jacey0-0/EE1111A-Project/schematic/BOM.csv

Reference | Value | Datasheet | Footprint | Qty | DNP
BT1 | Battery_Cell | Li-On Battery, 1 Single Cell |  | 1
C1 | 100uF |  |  | 1
C2 | 47uF |  |  | 1
C3 | 0.1uF |  |  | 1
C4 | 100nF |  |  | 1
C5 | 10uF |  |  | 1
D1,D2 | 1N5819 |  |  | 2
J1 | Power |  | Connector_PinSocket_2.54mm:PinSocket_1x08_P2.54mm_Vertical | 1
J2,J4 | Digital/PWM |  | Connector_PinSocket_2.54mm:PinSocket_1x08_P2.54mm_Vertical,Connector_PinSocket_2.54mm:PinSocket_1x10_P2.54mm_Vertical | 2
J3 | Analog |  | Connector_PinSocket_2.54mm:PinSocket_1x06_P2.54mm_Vertical | 1
L1 | 150uH |  |  | 1
M1 | Motor_Servo |  |  | 1
Q1,Q6 | 2N2222 | https://ngspice.sourceforge.io/docs/ngspice-html-manual/manual.xhtml#cha_BJTs |  | 2
Q2 | PN2907A | https://ngspice.sourceforge.io/docs/ngspice-html-manual/manual.xhtml#cha_BJTs |  | 1
Q3 | IRF9530 | https://ngspice.sourceforge.io/docs/ngspice-html-manual/manual.xhtml#cha_MOSFETs |  | 1
Q4 | IRLZ44N | http://www.irf.com/product-info/datasheets/data/irlz44n.pdf | Package_TO_SOT_THT:TO-220-3_Vertical | 1
Q5 | Q_Dual_NMOS_G1S2G2D2S1D1 |  |  | 1
R1,R2,R4,R9 | 10k |  |  | 4
R3 | 1k |  |  | 1
R5 | 470 |  |  | 1
R6 | 0.5R |  |  | 1
R7 | 100R |  |  | 1
R8 | 180k |  |  | 1
R10 | 2k |  |  | 1
R11,R12 | A1060 | http://cdn-reichelt.de/documents/datenblatt/A500/A106012.pdf | OptoDevice:R_LDR_D6.4mm_P3.4mm_Vertical | 2
R13 | 4.7k |  |  | 1
SC1 | Solar_Cell | 5W 12V |  | 1
U1,U5 | INA219AxD | http://www.ti.com/lit/ds/symlink/ina219.pdf | Package_SO:SOIC-8_3.9x4.9mm_P1.27mm | 2
U2,U4 | LM358 | http://www.ti.com/lit/ds/symlink/lm2904-n.pdf |  | 2
U3 | DW01A | https://hmsemi.com/downfile/DW01A.PDF | Package_TO_SOT_SMD:SOT-23-6 | 1
