jacey0-0/EE1111A-Project/schematic/EE1111A.pdf

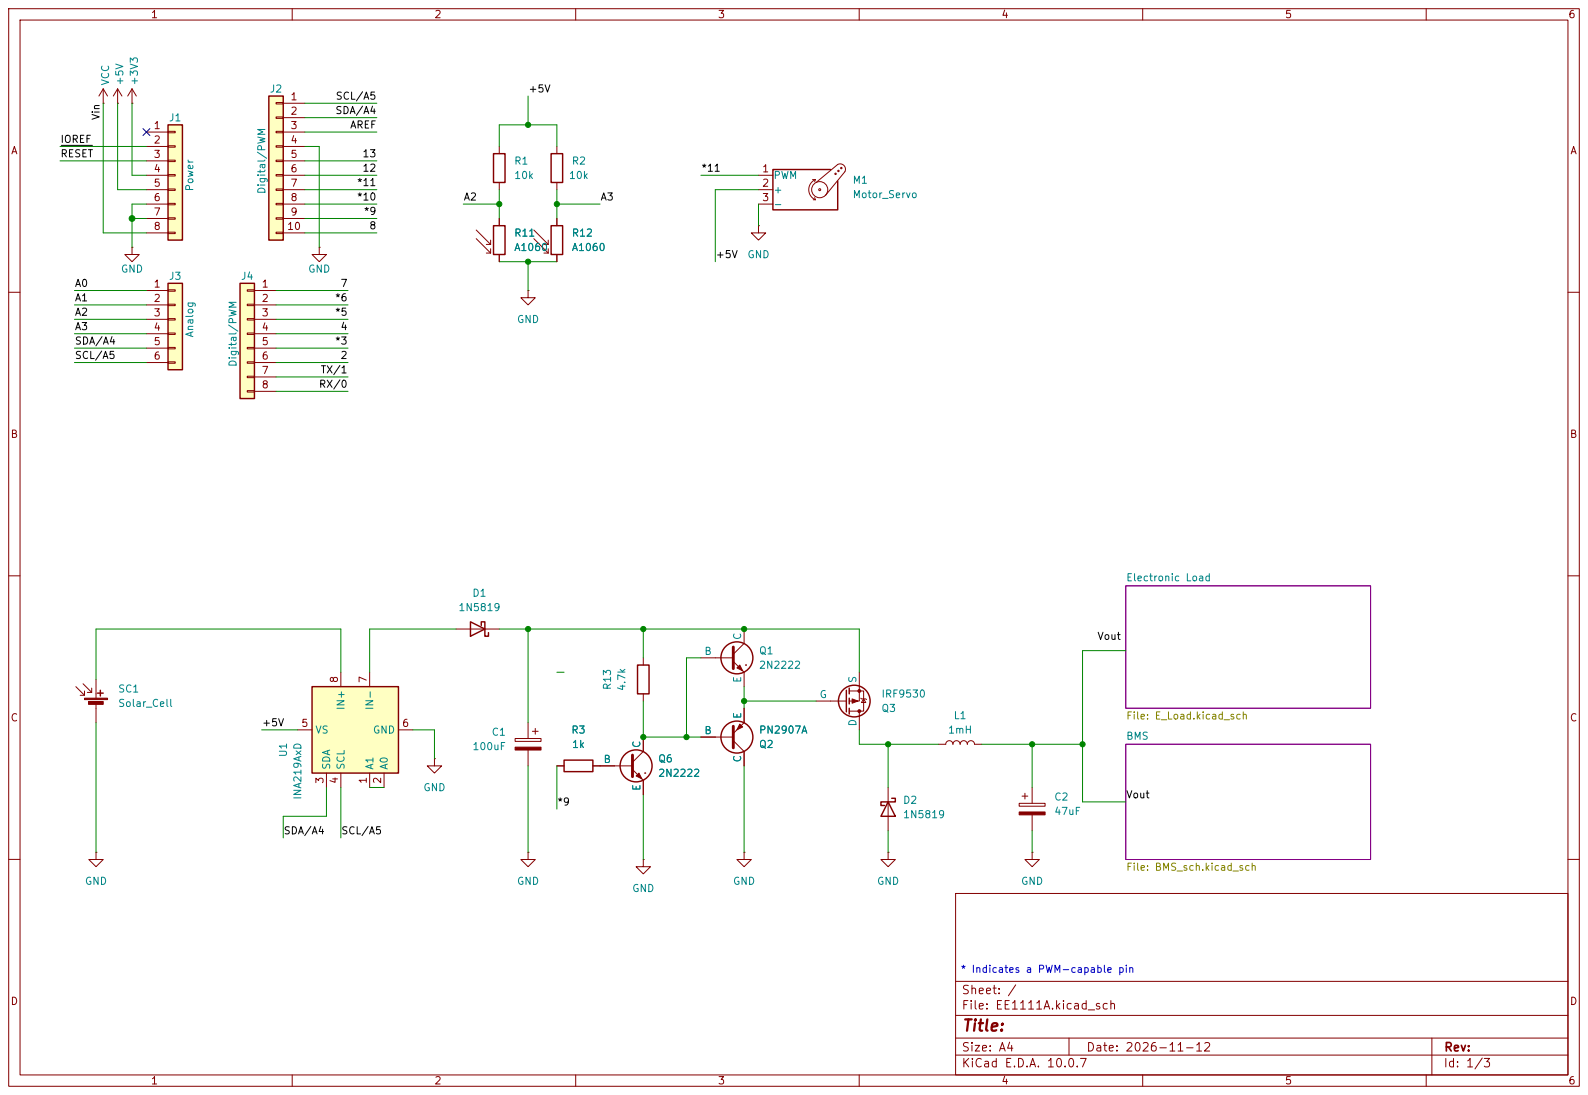
[picture p3: page 1]

* Indicates a PWM-capable pin Q2PN2907A C

Size: A4 | Rev:
KiCad E.D.A. 10.0.7 | Id: 1/3

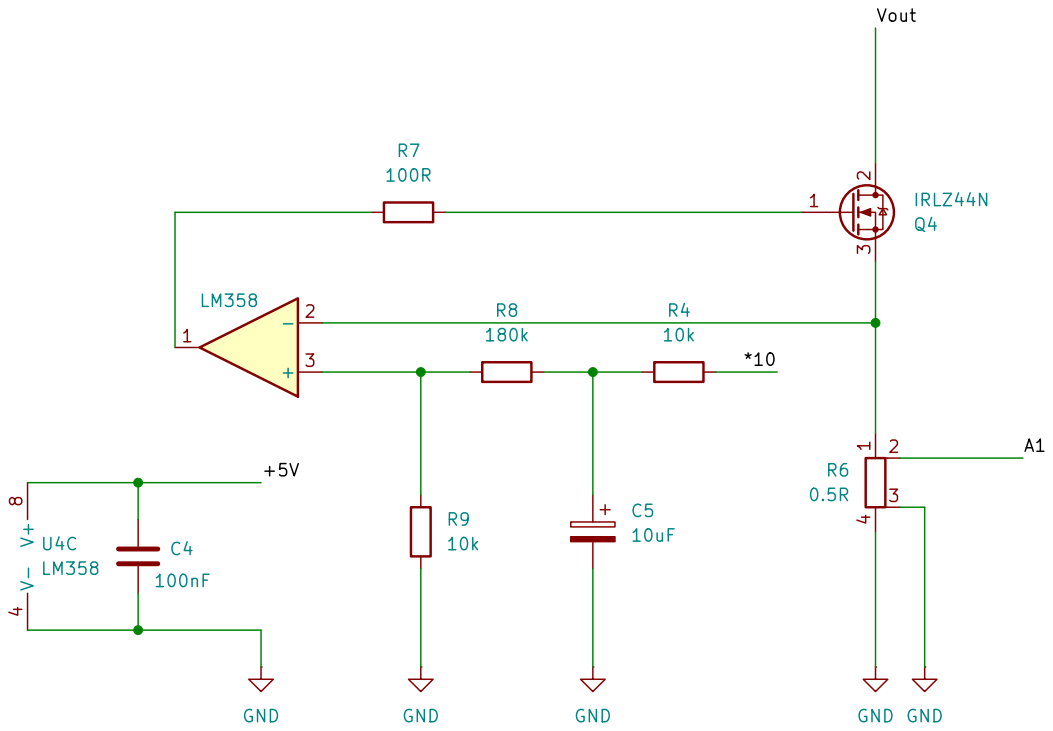
[picture p4: page 2]

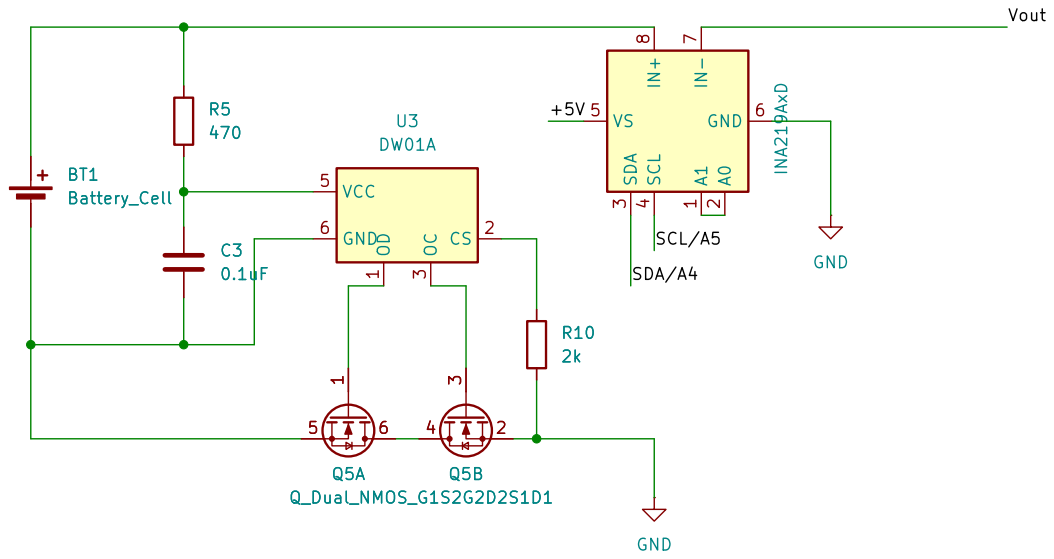
[picture p5: page 3]
