jacey0-0/EE1111A-Project/schematic/EE1111A.kicad_pcb

## KiCad design schematic/EE1111A.kicad_pcb (2026-10-20)


Board: 2 copper layers, 68.6 x 53.3 mm, 8 parts (0 on the bottom side), 3 nets, no tracks yet.

Parts:
J1: Power; PinSocket_1x08_P2.54mm_Vertical
J2: Digital/PWM; PinSocket_1x10_P2.54mm_Vertical
J3: Analog; PinSocket_1x06_P2.54mm_Vertical
J4: Digital/PWM; PinSocket_1x08_P2.54mm_Vertical
MH1, MH2, MH3, MH4: MountingHole_3.2mm

Connections:
/SCL/A5: J2.1, J3.6
/SDA/A4: J2.2, J3.5
GND: J1.6, J1.7, J2.4
