jacey0-0/EE1111A-Project/(commit log)

2026-10-15 Create BOM.md
    Bill of Materials
2026-10-20 Simulation Verified Schematic
    [EE1111A.kicad_sch]
2026-10-20 Convert BOM from markdown to CSV format
    [BOM.csv]
2026-10-20 Fixed Errors
    [BMS_sch.kicad_sch, EE1111A.kicad_pcb, EE1111A.kicad_sch, E_Load.kicad_sch]
2026-10-20 Fixed BOM.csv
    [BOM.csv]
2026-10-20 Basic Arduino Control Code
2026-11-10 Fixed Bugs and Tuned Tracking
    [Controller.ino]
2026-11-11 Revise README for comprehensive project documentation
    Updated README to include project overview, architecture, hardware selection, and detailed sections on buck converter design, PWM architecture, MPPT, battery management, programmable load, solar tracking, telemetry, and known limitations.
2026-11-11 Update known limitations and further work in README
    Expanded the known limitations section with detailed suggestions for improving MPPT convergence, charging safety, load current measurement, and higher-power PV testing.
2026-11-11 Fixed Bugs in code
    [Controller.ino]
